rt-net/RaspberryPiGibbon/CAD/汎用パーツ/ジュラコンスペーサー（六角）_BS-2615E.png

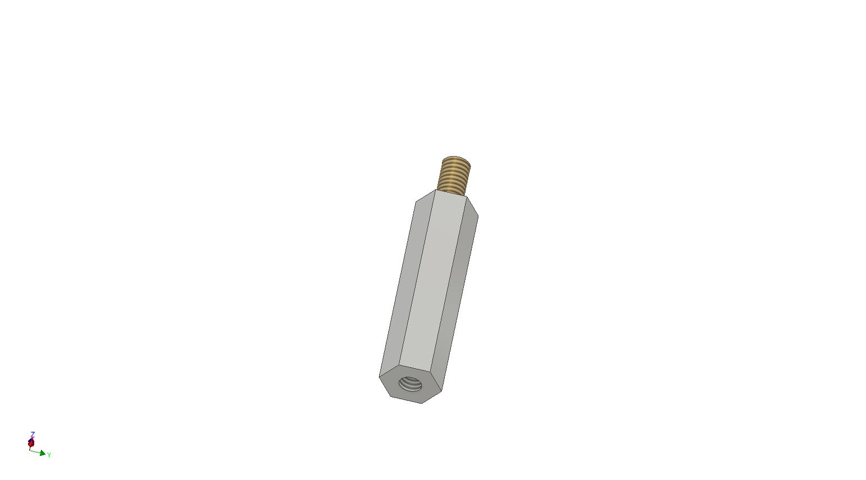
CAD/汎用パーツ/ジュラコンスペーサー（六角）_BS-2615E.png
