rt-net/RaspberryPiGibbon/CAD/3Dプリント用STLデータ/RasPiArm-HandA.stl

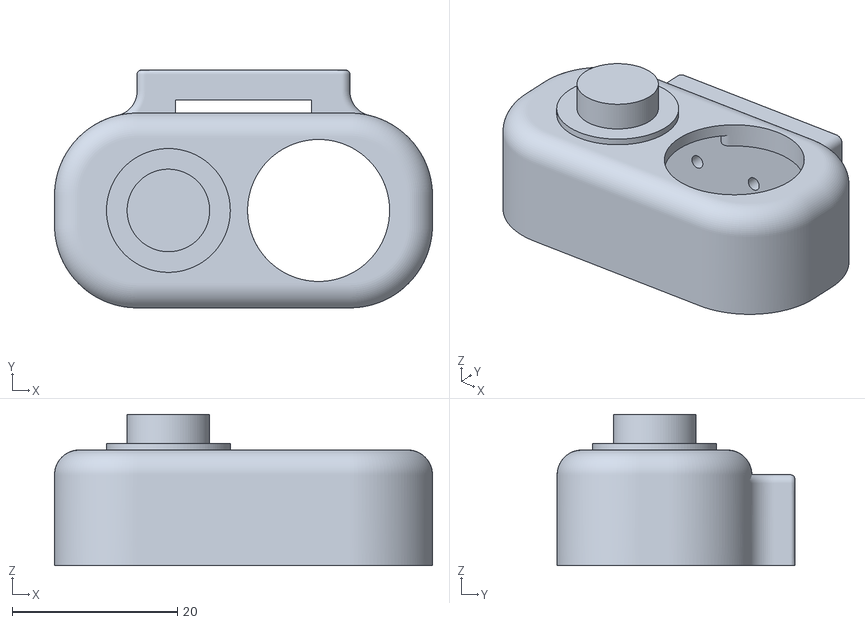
[picture p2: CAD file, 2017-02-24]
CAD/3Dプリント用STLデータ/RasPiArm-HandA.stl
45.8 x 28.8 x 18.3
