rt-net/RaspberryPiGibbon/CAD/3Dプリント用STLデータ/RasPiArm-HandF.stl

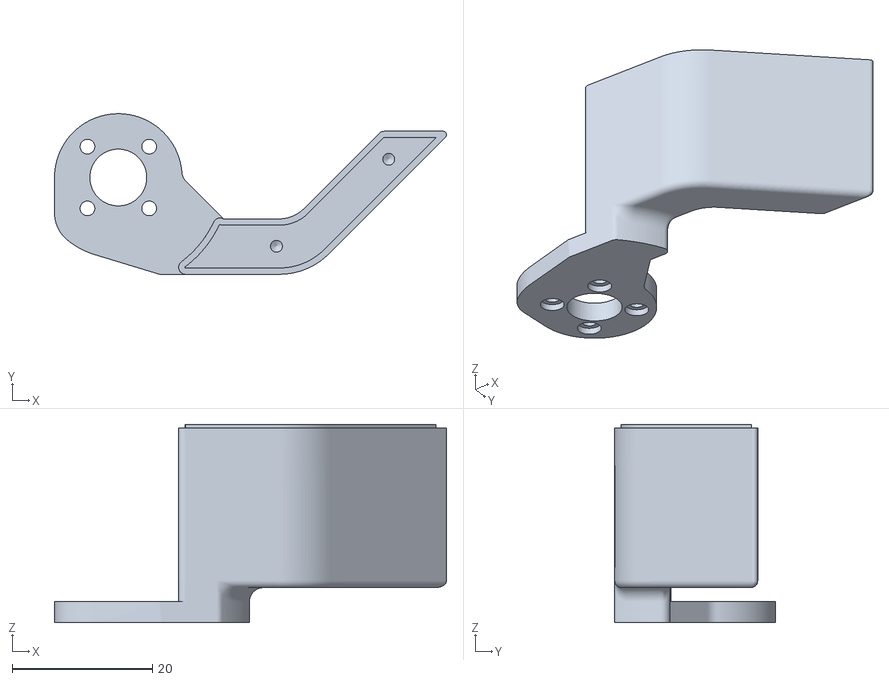
[picture p4: CAD file, 2017-02-24]
CAD/3Dプリント用STLデータ/RasPiArm-HandF.stl
55.9 x 22.9 x 28.3
