rt-net/RaspberryPiGibbon/CAD/3Dプリント用STLデータ/RasPiArm-HandC.stl

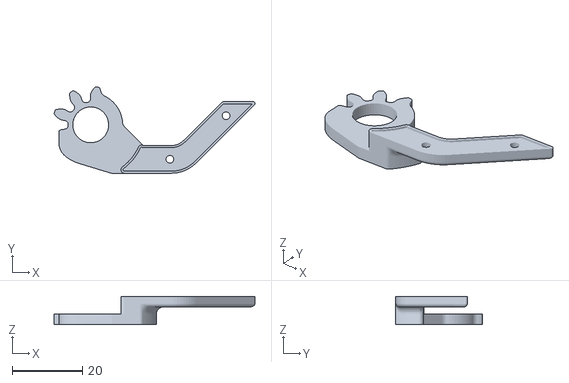
[picture p7: CAD file, 2017-02-24]
CAD/3Dプリント用STLデータ/RasPiArm-HandC.stl
57.3 x 24.7 x 8.00
