rt-net/RaspberryPiGibbon/CAD/3Dプリント用STLデータ/RasPiArm-HandB.stl

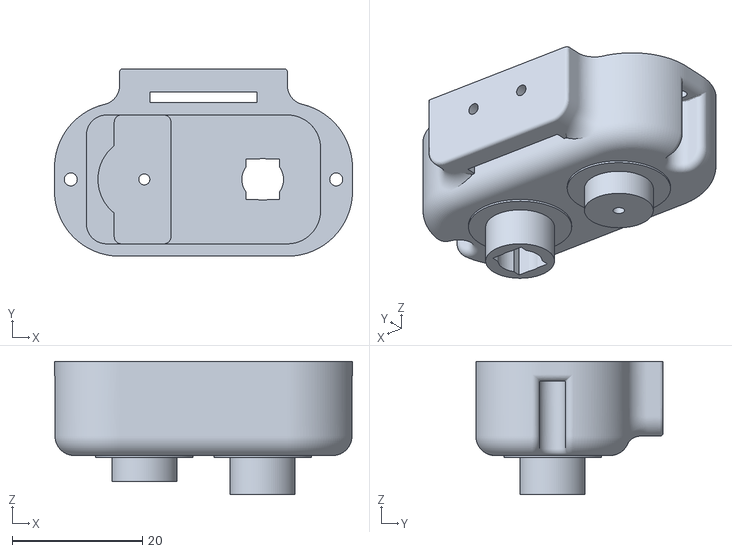
[picture p8: CAD file, 2017-02-24]
CAD/3Dプリント用STLデータ/RasPiArm-HandB.stl
45.8 x 28.8 x 20.5
