rt-net/RaspberryPiGibbon/CAD/3Dプリント用STLデータ/ボードガード.stl

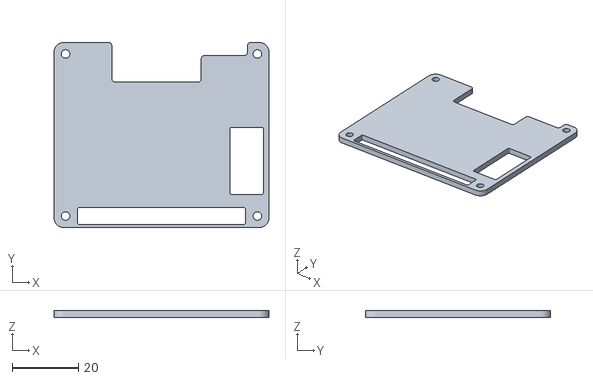
[picture p9: CAD file, 2017-02-24]
CAD/3Dプリント用STLデータ/ボードガード.stl
65.0 x 56.0 x 2.00
