rt-net/RaspberryPiGibbon/CAD/3Dプリント用STLデータ/ヨー軸スペーサ.stl

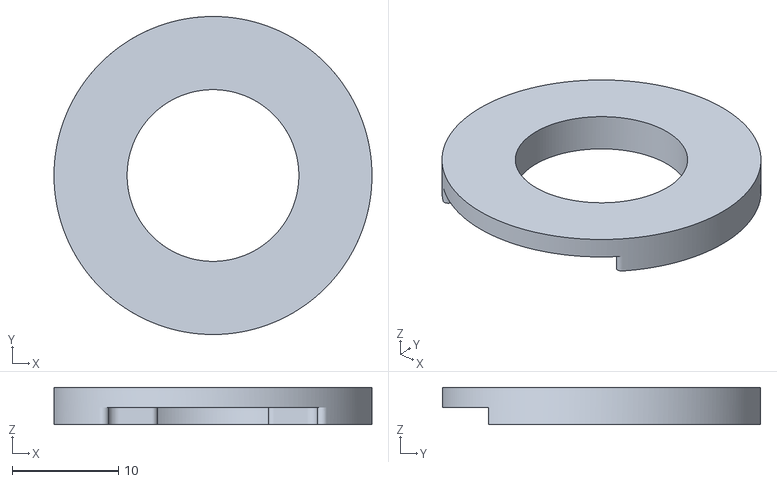
[picture p10: CAD file, 2017-02-24]
CAD/3Dプリント用STLデータ/ヨー軸スペーサ.stl
30.0 x 30.0 x 3.50
