rt-net/RaspberryPiGibbon/CAD/3Dプリント用STLデータ/RasPiArm-HandD.stl

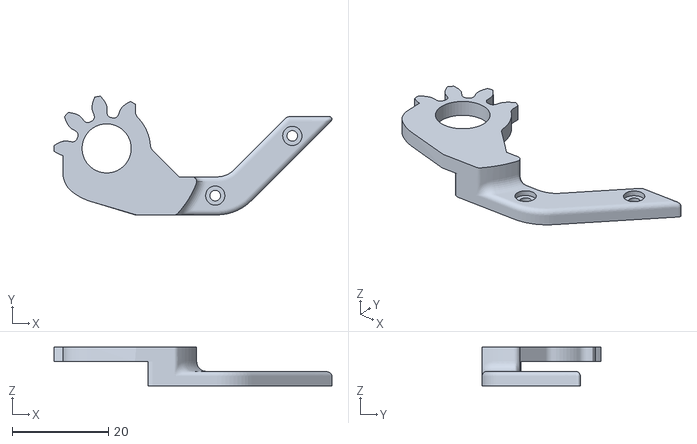
[picture p11: CAD file, 2017-02-24]
CAD/3Dプリント用STLデータ/RasPiArm-HandD.stl
57.7 x 24.7 x 8.00
