rt-net/RaspberryPiGibbon/(list of files, cad)

Other CAD files:
CAD/RasPiArm-HandA.ipt
CAD/RasPiArm-HandB.ipt
CAD/RasPiArm-HandC.ipt
CAD/RasPiArm-HandD.ipt
CAD/RasPiArm-HandE.ipt
CAD/RasPiArm-HandF.ipt
CAD/RasPiArm-HandG.ipt
CAD/RasPiArm20170203.iam
CAD/フレームC.ipt
CAD/ボードガード.ipt
CAD/ヨー軸スペーサ.ipt
CAD/図面/RasPiArm.idw
CAD/図面/RasPiGibbonFlame.idw
CAD/図面/中継ハブ.idw
CAD/手先カメラ.ipt
CAD/汎用パーツ/3Dデータ/M2スペーサ_ASB-2010E.ipt
CAD/汎用パーツ/3Dデータ/OldVersions/PR-4S780P.0005.ipt
CAD/汎用パーツ/3Dデータ/OldVersions/RPU-11.0003.ipt
CAD/汎用パーツ/3Dデータ/OldVersions/RRC-R11.0004.ipt
CAD/汎用パーツ/3Dデータ/OldVersions/RS30x.0001.ipt
CAD/汎用パーツ/3Dデータ/OldVersions/RS30x_BottomShaft.0004.ipt
CAD/汎用パーツ/3Dデータ/OldVersions/RS30x_FreeHorn.0003.ipt
CAD/汎用パーツ/3Dデータ/OldVersions/RS30x_ServoHorn.0003.ipt
CAD/汎用パーツ/3Dデータ/OldVersions/TB-22PP.0001.ipt
CAD/汎用パーツ/3Dデータ/PR-4S780P.ipt
CAD/汎用パーツ/3Dデータ/RPU-11.ipt
CAD/汎用パーツ/3Dデータ/RRC-R11.ipt
CAD/汎用パーツ/3Dデータ/RS30x.ipt
CAD/汎用パーツ/3Dデータ/RS30x_BottomShaft.ipt
CAD/汎用パーツ/3Dデータ/RS30x_FreeHorn.ipt
CAD/汎用パーツ/3Dデータ/RS30x_ServoHorn.ipt
CAD/汎用パーツ/3Dデータ/TB-22PP.ipt
CAD/汎用パーツ/3Dデータ/TB-RV71EH.ipt
CAD/汎用パーツ/3Dデータ/中空スペーサ_C-2003.ipt
CAD/汎用パーツ/40187a.ipt
CAD/汎用パーツ/40187b.ipt
CAD/汎用パーツ/G-ROBOTSアルミブラケットC.ipt
CAD/汎用パーツ/G-ROBO_Arm.ipt
CAD/汎用パーツ/ISO 4032 - M2 - ISO.ipt
CAD/汎用パーツ/ISO 4032 - M2.5ISO.ipt
CAD/汎用パーツ/ISO 7045 - M2 x 4 - 4.8 - HISO.ipt
CAD/汎用パーツ/ISO 7045 - M2.5 x 5 - 4.8 - H - ISO.ipt
CAD/汎用パーツ/ISO 7045 - M3 x 10 - 4.8 - HISO.ipt
CAD/汎用パーツ/ISO 7045 - M3 x 6 - 4.8 - H - ISO.ipt
CAD/汎用パーツ/M2ナットレンチ.ipt
CAD/汎用パーツ/RasPiArm基板/14377.ipt
CAD/汎用パーツ/RasPiArm基板/OldVersions/14377.0003.ipt
CAD/汎用パーツ/RasPiArm基板/OldVersions/RasPiArm基板.0007.iam
CAD/汎用パーツ/RasPiArm基板/OldVersions/RasPiArm基板.0008.ipt
CAD/汎用パーツ/RasPiArm基板/RasPiArm基板.iam
CAD/汎用パーツ/RasPiArm基板/RasPiArm基板.ipt
CAD/汎用パーツ/Raspberry Pi B+.ipt
CAD/汎用パーツ/USBブリッジ基板/OldVersions/USBブリッジ基板.0003.iam
CAD/汎用パーツ/USBブリッジ基板/OldVersions/USBブリッジ基板1.0004.ipt
CAD/汎用パーツ/USBブリッジ基板/OldVersions/USBブリッジ基板2.0002.ipt
CAD/汎用パーツ/USBブリッジ基板/USBブリッジ基板.iam
CAD/汎用パーツ/USBブリッジ基板/USBブリッジ基板1.ipt
CAD/汎用パーツ/USBブリッジ基板/USBブリッジ基板2.ipt
CAD/汎用パーツ/camerapi.ipt
CAD/汎用パーツ/アルミスペーサー(六角・酸洗処理）_ASL-3100E.ipt
CAD/汎用パーツ/アルミスペーサー(六角・酸洗処理）_ASL-370E.ipt
CAD/汎用パーツ/アルミスペーサー(六角・酸洗処理）_ASL-380E.ipt
CAD/汎用パーツ/ジュラコンスペーサー（六角・短間段重ね用）_MS-2006-03E.ipt
CAD/汎用パーツ/ジュラコンスペーサー（六角）_AS-2616.ipt
CAD/汎用パーツ/ジュラコンスペーサー（六角）_AS-330B.ipt
CAD/汎用パーツ/ジュラコンスペーサー（六角）_AS-335B.ipt
CAD/汎用パーツ/ジュラコンスペーサー（六角）_AS-340B.ipt
CAD/汎用パーツ/ジュラコンスペーサー（六角）_BS-2006E.ipt
CAD/汎用パーツ/ジュラコンスペーサー（六角）_BS-2606E.ipt
CAD/汎用パーツ/ジュラコンスペーサー（六角）_BS-2611E.ipt
CAD/汎用パーツ/ジュラコンスペーサー（六角）_BS-2616E.ipt
CAD/汎用パーツ/ジュラコンスペーサー（六角）_BS-2620E.ipt
CAD/汎用パーツ/ステンレススペーサー（六角）_BSU-310.ipt
CAD/汎用パーツ/ステンレススペーサー（六角）_BSU-3100.ipt
CAD/汎用パーツ/ナイロンスペーサー(中空）外径3.7内径2.2長3_CN-2003.ipt
CAD/汎用パーツ/中継ハブ.ipt
CAD/汎用パーツ/六角穴付低頭平 M3 x 10.ipt
CAD/汎用パーツ/六角穴付低頭平 M3 x 6.ipt
CAD/汎用パーツ/六角穴付低頭平 M3 x 8.ipt
CAD/汎用パーツ/単３電池.ipt
CAD/汎用パーツ/超広角カメラ_MCM-4350FISH.ipt
CAD/汎用パーツ/黄銅スペーサー（六角）_ASB-2613.5E.ipt
CAD/汎用パーツ/黄銅スペーサー（六角）_ASB-330E.ipt
CAD/汎用パーツ/ＳＮ型電池ホルダー_SN3-6B.ipt
