rt-net/RaspberryPiGibbon/RaspberryPiGibbonCircuit.pdf

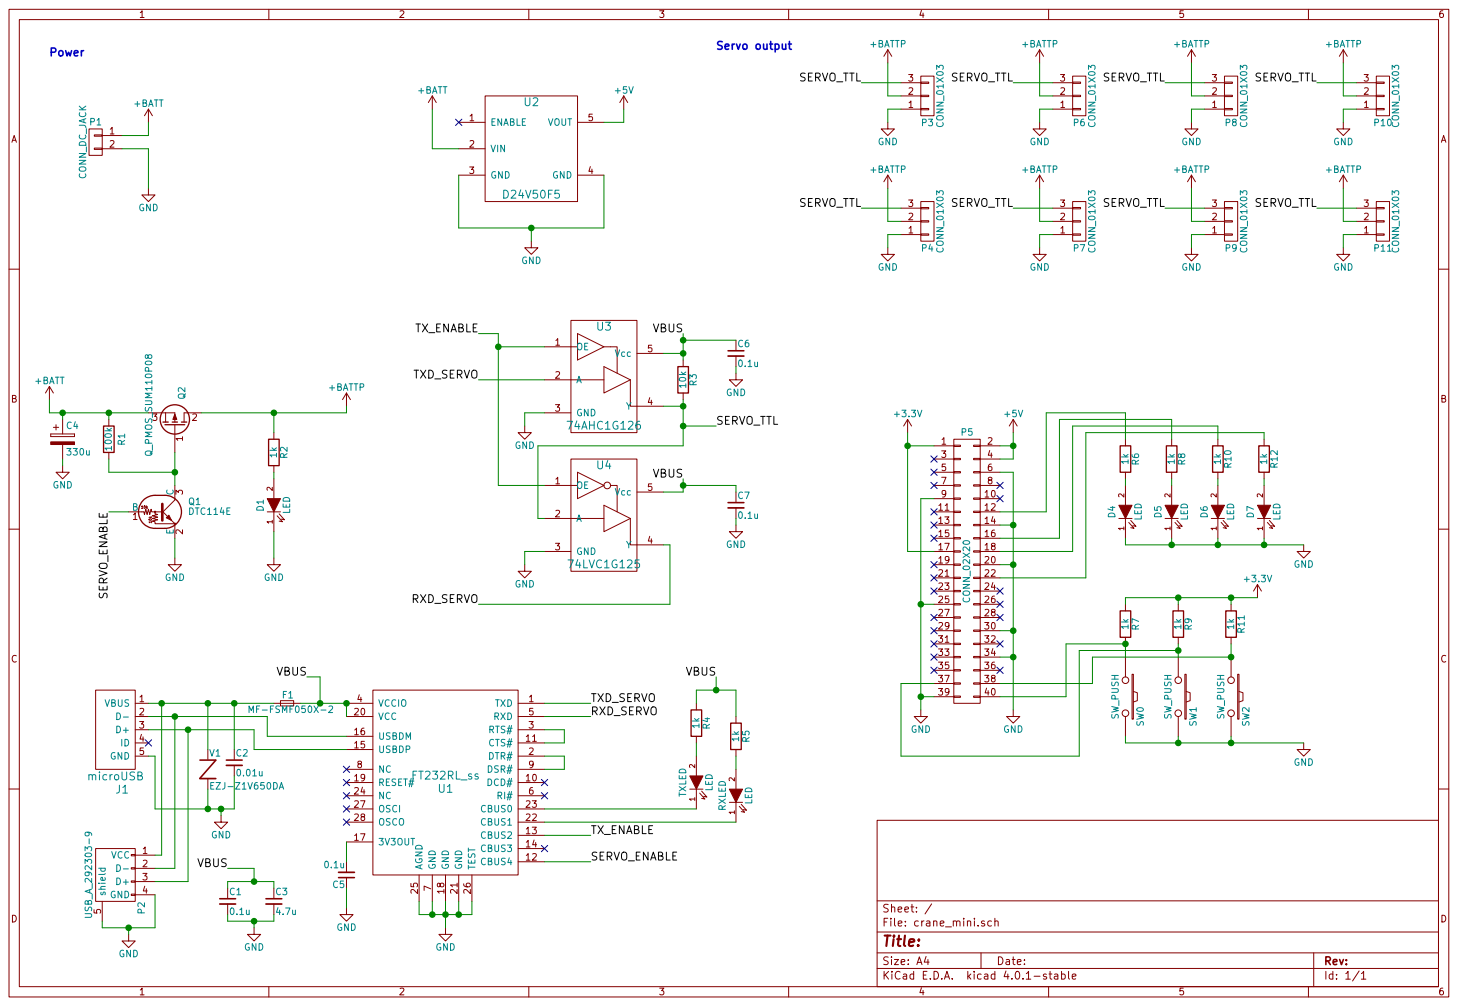
[picture p12: page 1]

7 NC 8 DSR# 9 DCD# 10 VCC 20 CTS# 11 GND 21 CBUS4 12 CBUS1 22 CBUS2 13 CBUS0 23 CBUS3 14 NC 24 USBDP 15 AGND 25 USBDM 16 TEST 26
