rt-net/RaspberryPiGibbon/CAD/図面/RasPiGibbonFlame.pdf

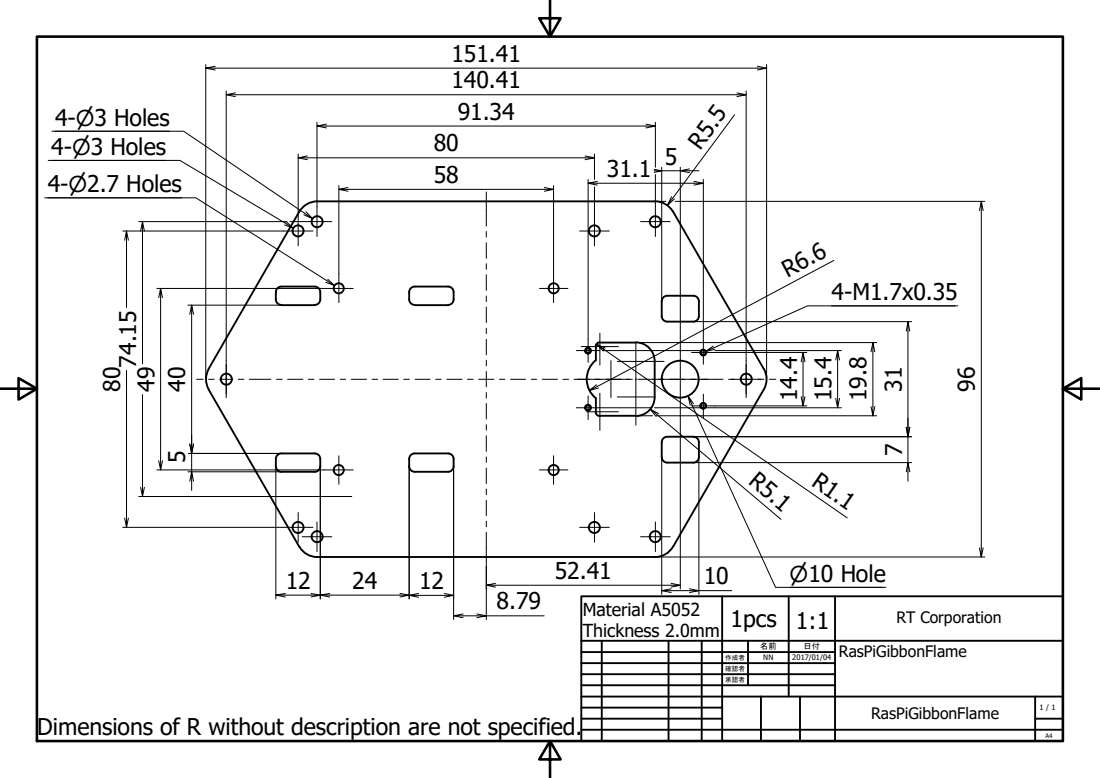
[picture p13: page 1]
RasPiGibbonFlame; RT Corporation; Material A5052 Thickness 2.0mm; 1pcs; 4-P2.7 Holes; 4-P3 Holes; P10 Hole

Dimensions of R without description are not specified.
