rt-net/RaspberryPiGibbon/CAD/図面/中継ハブ.pdf

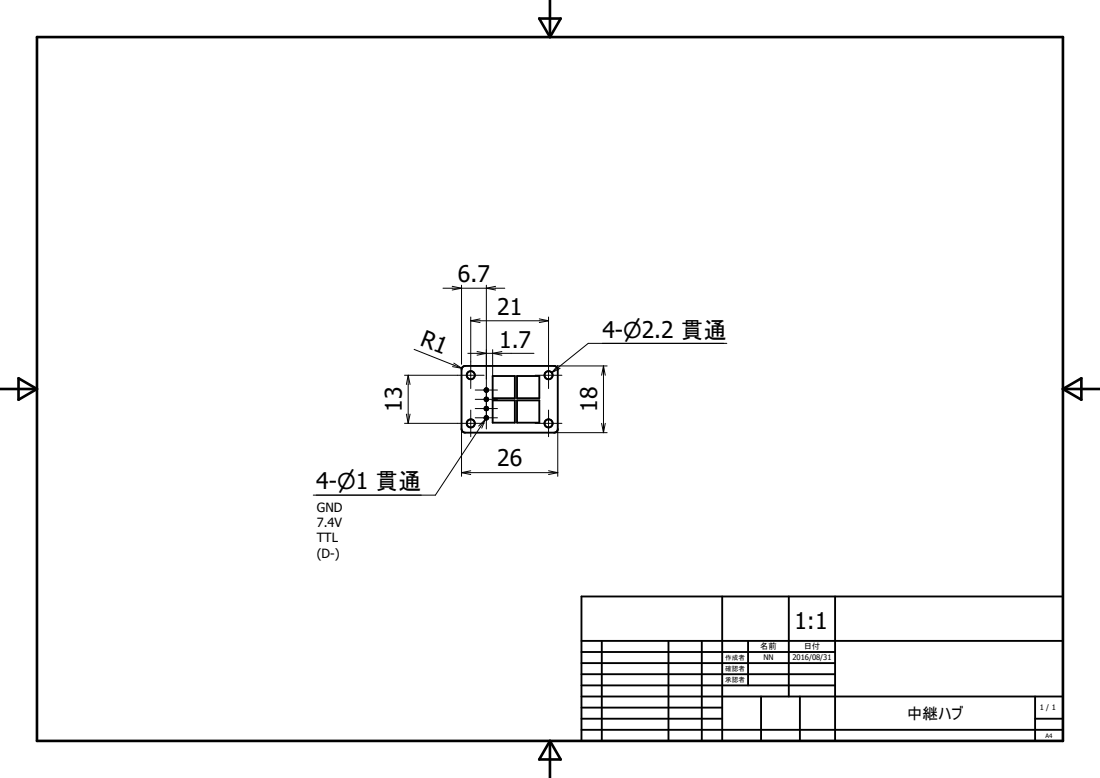
[picture p14: page 1]
中継ハブ; GND 7.4V TTL (D-)

作成者
確認者

承認者
