rt-net/RaspberryPiGibbon/CAD/図面/RasPiArm 20161028.pdf

1

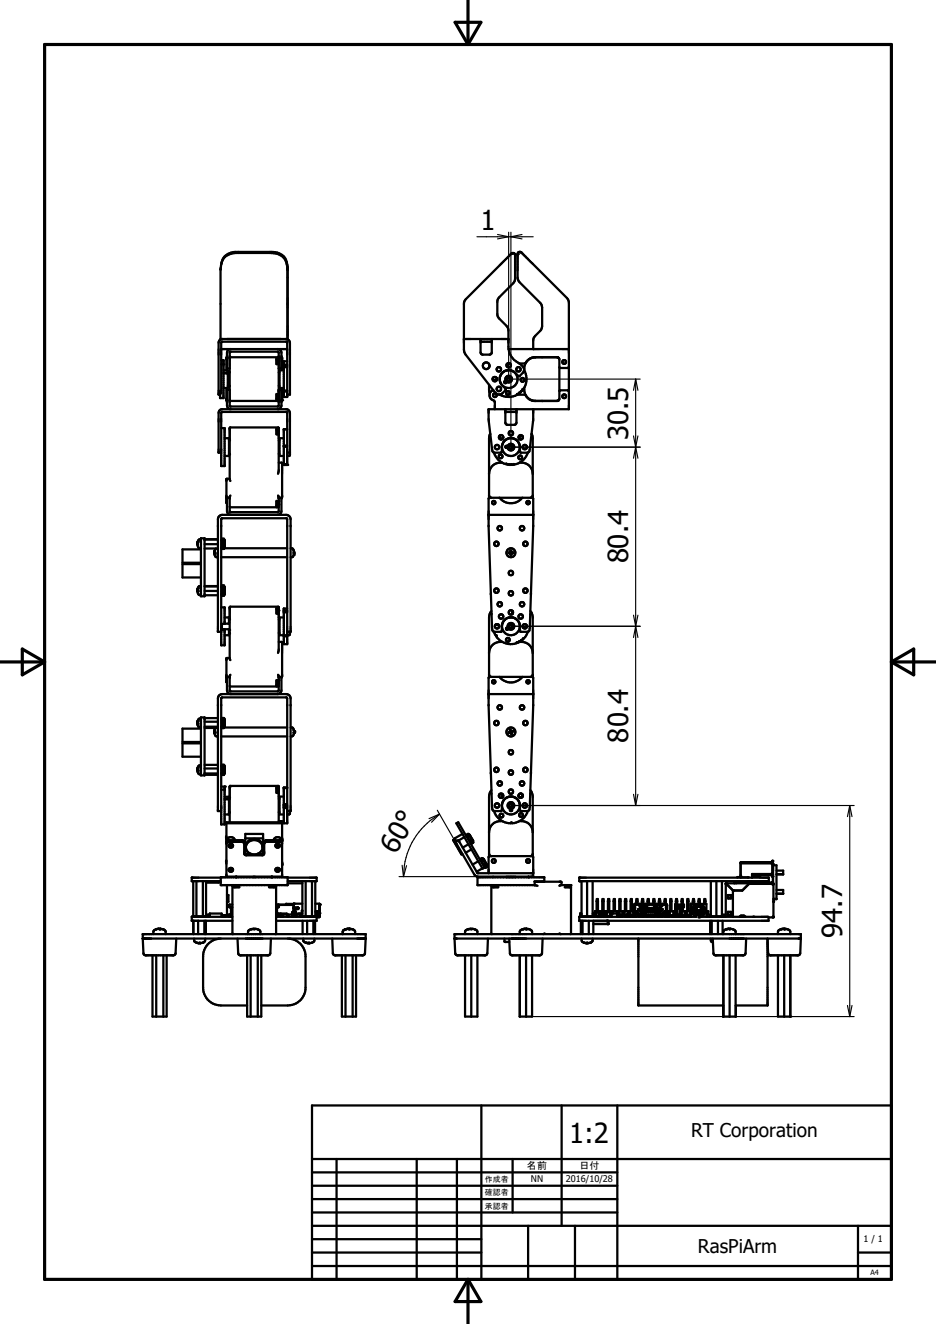
[picture p15: page 1]
RasPiArm; RT Corporation; 作成者; 確認者; 承認者
