rt-net/RaspberryPiGibbon/CAD/図面/USBブリッジ基板.pdf

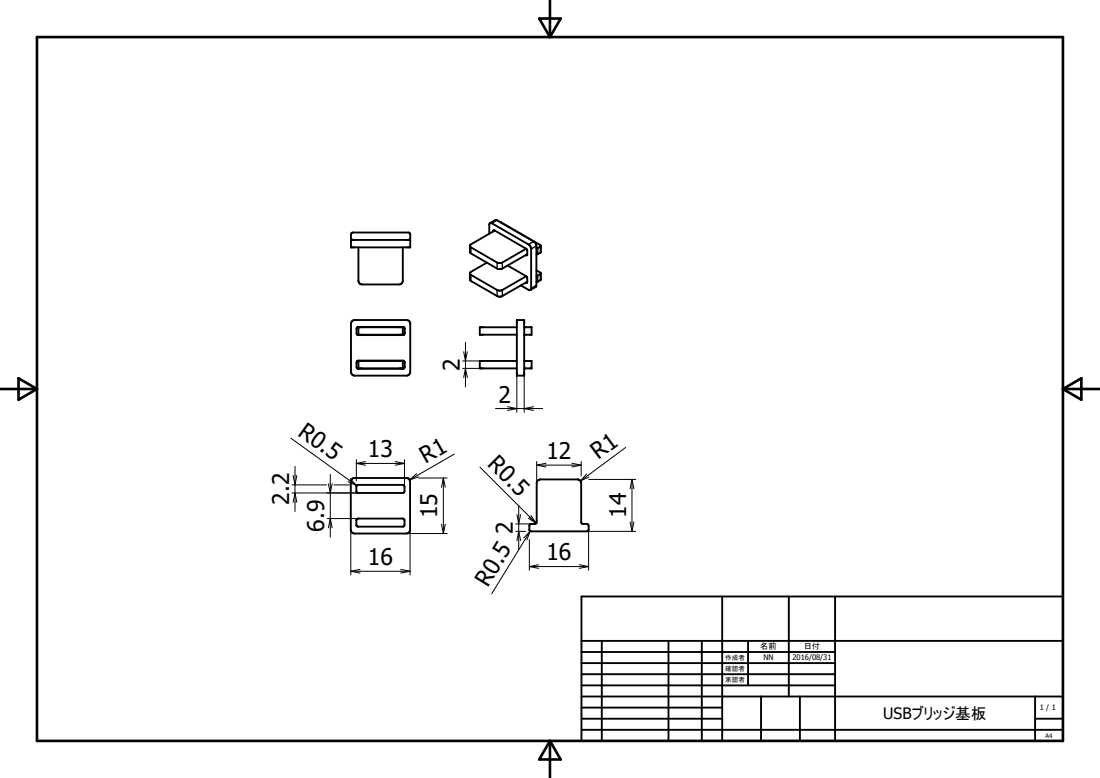
[picture p16: page 1]
USBブリッジ基板

作成者
確認者

承認者
