rt-net/RaspberryPiGibbon/(commit log)

2016-12-28 Create CAD
2017-02-06 Update CAD dir
2017-02-24 Inventor or Fusion360 Design Data
    [14377.0003.ipt, 14377.ipt, G-ROBOTSアルミブラケットC.ipt, ISO 4032 - M2 - ISO.ipt, ISO 4032 - M2.5ISO.ipt, ISO 7045 - M2 x 4 - 4.8 - HISO.ipt, ISO 7045 - M2.5 x 5 - 4.8 - H - ISO.ipt, ISO 7045 - M3 x 10 - 4.8 - HISO.ipt]
2017-02-24 Update assembly Data
    [G-ROBOTSアルミブラケットC.ipt, RasPiArm20170203.iam, RasPiArm基板.iam, USBブリッジ基板.iam]
2017-02-24 Add assembly data STEP & IGES
    [RasPiArm20170203.stp]
